klaus-liebler/kicad-libs/smopla.3d/Fan_Assembly.stp

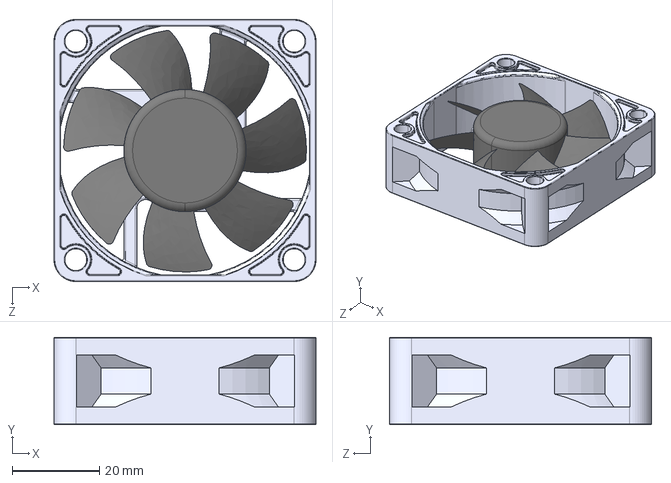
[picture p1: CAD file, 2021-04-30, last stored version]
smopla.3d/Fan_Assembly.stp
60.0 x 20.0 x 60.0 mm
Fan_Case
Fan
