klaus-liebler/kicad-libs/smopla.3d/HANRUN HR911105A.stp

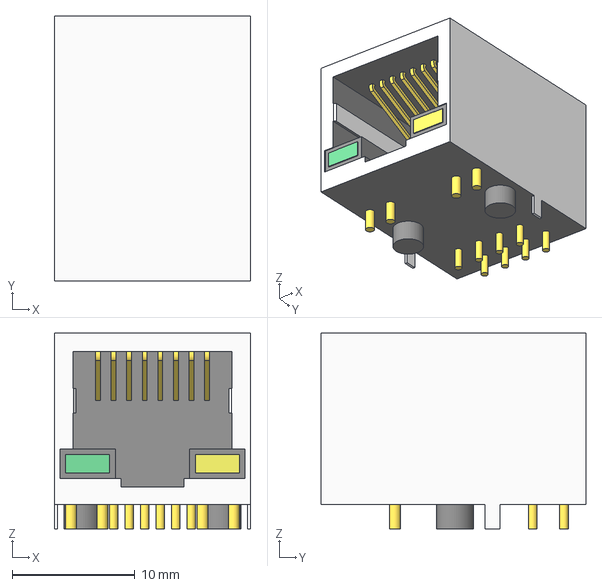
[picture p2: CAD file, 2021-04-30, last stored version]
smopla.3d/HANRUN HR911105A.stp
16.0 x 21.6 x 15.9 mm
contact x 8
