klaus-liebler/kicad-libs/smopla.3d/MiniPIR v1.f3d.__gcx3d__.stp

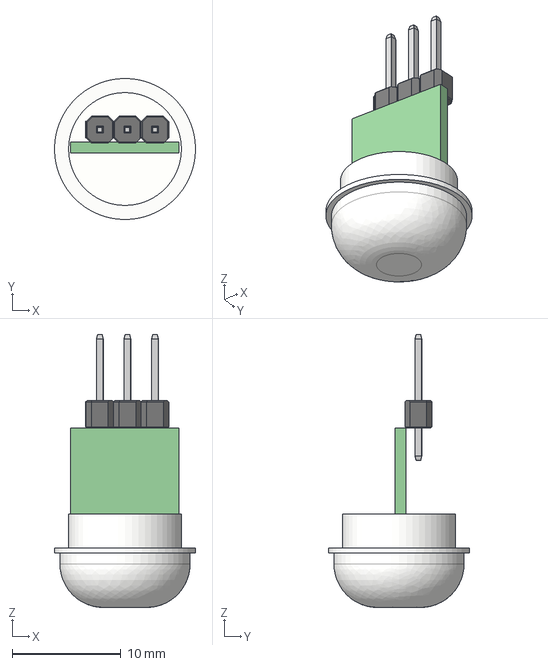
[picture p3: CAD file, 2021-04-30, last stored version]
smopla.3d/MiniPIR v1.f3d.__gcx3d__.stp
13.0 x 13.0 x 25.2 mm
