klaus-liebler/kicad-libs/smopla.3d/Button.SLDPRT

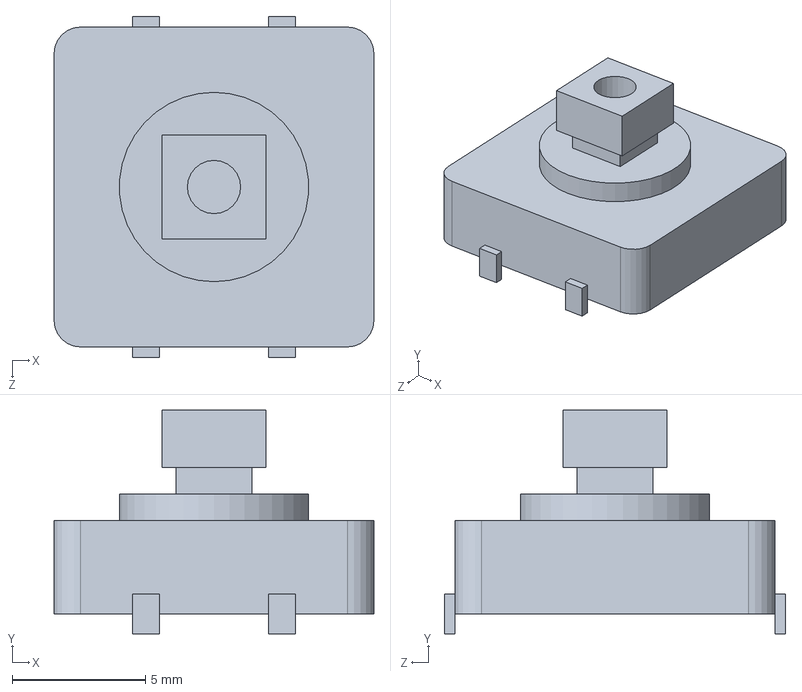
[picture p4: CAD file, 2021-04-30, last stored version]
smopla.3d/Button.SLDPRT
12.0 x 8.40 x 12.8 mm
