klaus-liebler/kicad-libs/smopla.3d/EC11_Rotary_Encoder_Switched.step

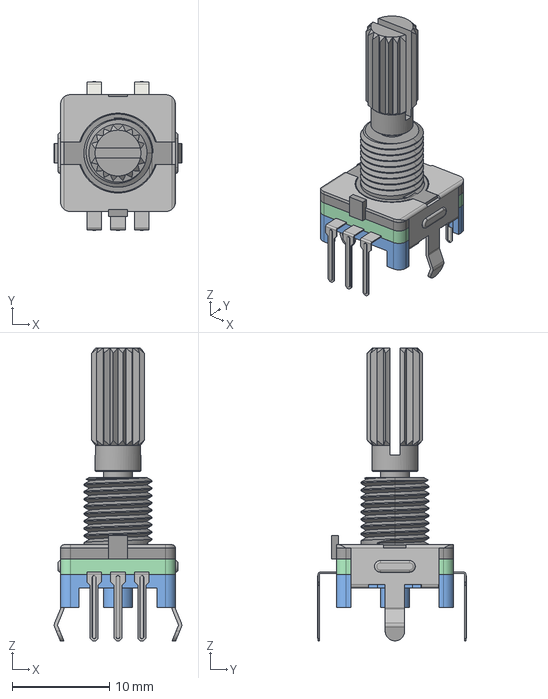
[picture p5: CAD file, 2021-04-30, last stored version]
smopla.3d/EC11_Rotary_Encoder_Switched.step
13.1 x 15.3 x 30.1 mm
