klaus-liebler/kicad-libs/smopla.3d/ALPHA-RD901F-40.step

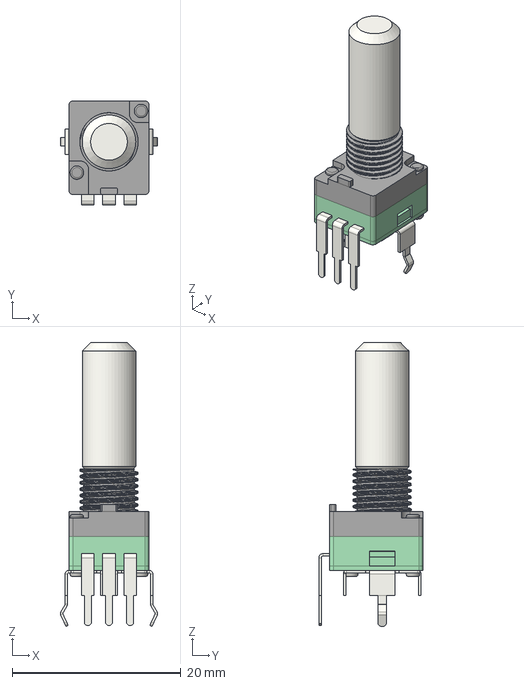
[picture p6: CAD file, 2021-04-30, last stored version]
smopla.3d/ALPHA-RD901F-40.step
11.5 x 12.4 x 33.6 mm
