klaus-liebler/kicad-libs/smopla.3d/Fiche_Banane_Noir.STEP

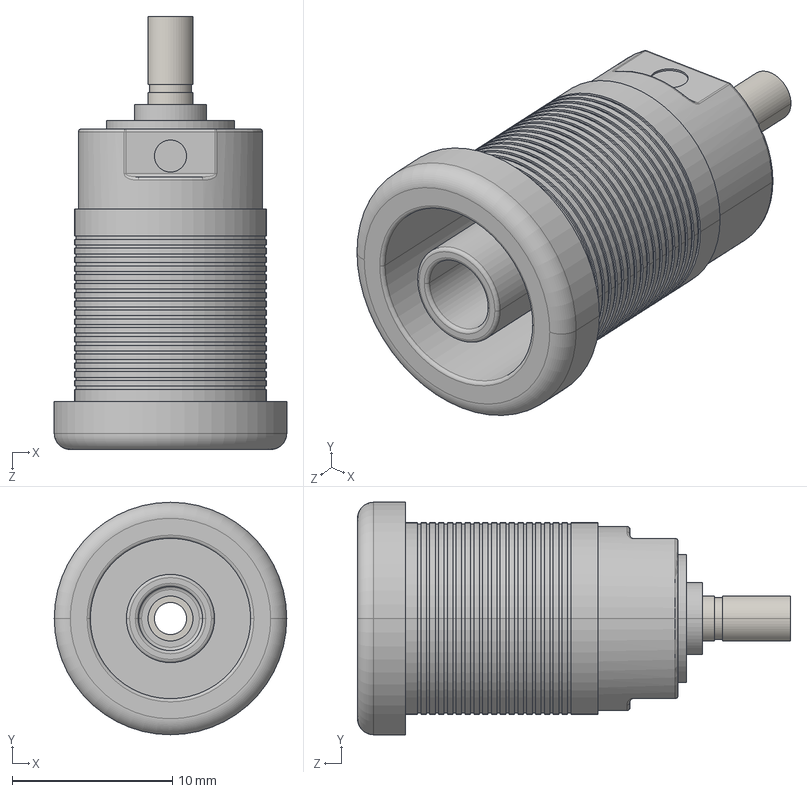
[picture p7: CAD file, 2021-04-30, last stored version]
smopla.3d/Fiche_Banane_Noir.STEP
14.5 x 14.5 x 27.0 mm
