klaus-liebler/kicad-libs/smopla.3d/16Bit I2C ADC+PGA - ADS1115.stp

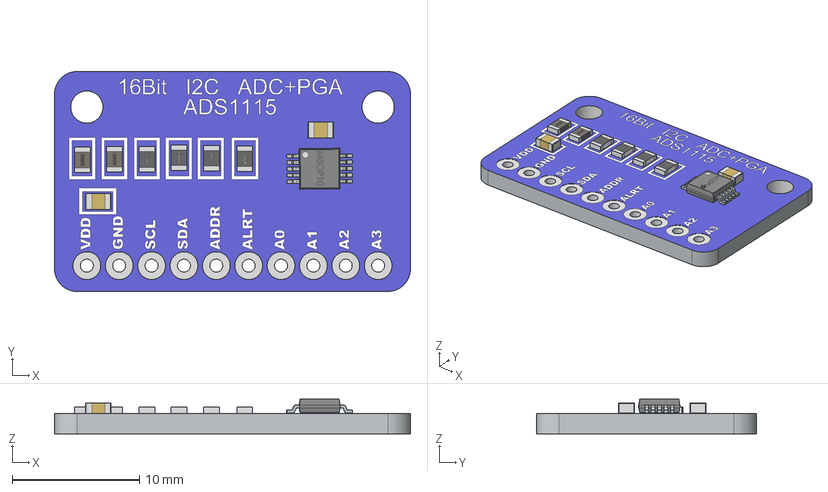
[picture p8: CAD file, 2021-04-30, last stored version]
smopla.3d/16Bit I2C ADC+PGA - ADS1115.stp
27.9 x 17.3 x 2.74 mm
ADS1115
0805 Capacitor x 2
0805 Inductor x 2
0805 Resistor x 4
MSOP10
