klaus-liebler/kicad-libs/smopla.3d/HC-SR501.STEP

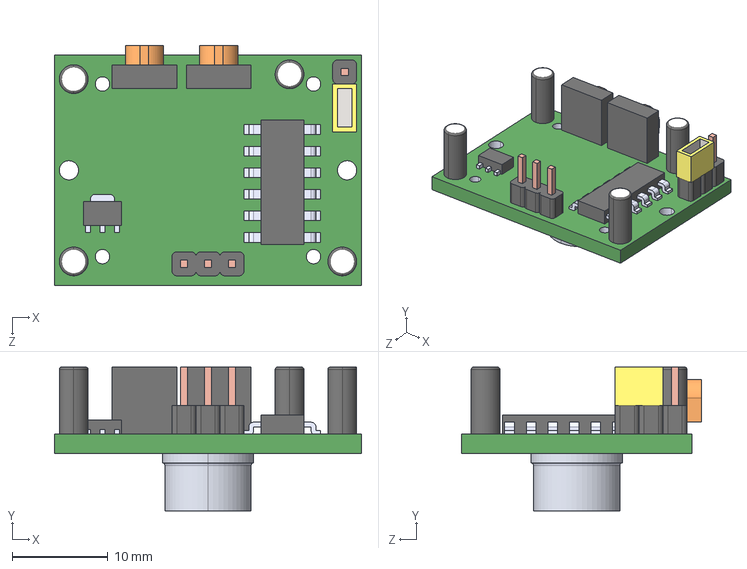
[picture p9: CAD file, 2021-04-30, last stored version]
smopla.3d/HC-SR501.STEP
32.0 x 15.0 x 25.0 mm
