klaus-liebler/kicad-libs/smopla.3d/LED 2835.stp

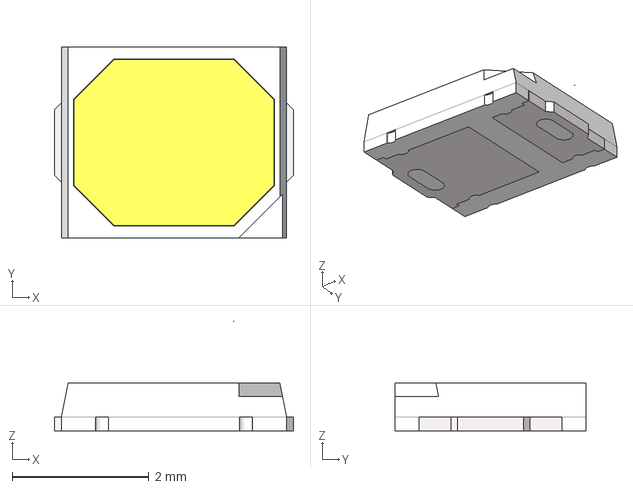
[picture p10: CAD file, 2021-04-30, last stored version]
smopla.3d/LED 2835.stp
3.50 x 2.80 x 1.61 mm
