klaus-liebler/kicad-libs/smopla.3d/ASPI-0630LR.STEP

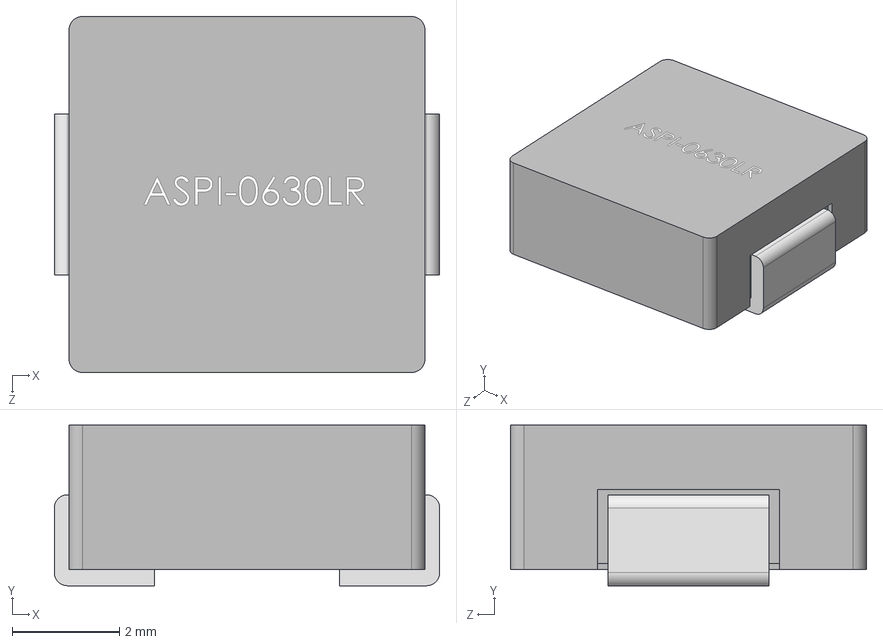
[picture p11: CAD file, 2021-04-30, last stored version]
smopla.3d/ASPI-0630LR.STEP
7.20 x 3.00 x 6.65 mm
