klaus-liebler/kicad-libs/smopla.3d/L-KLS7-SS-12F20A-G5.step

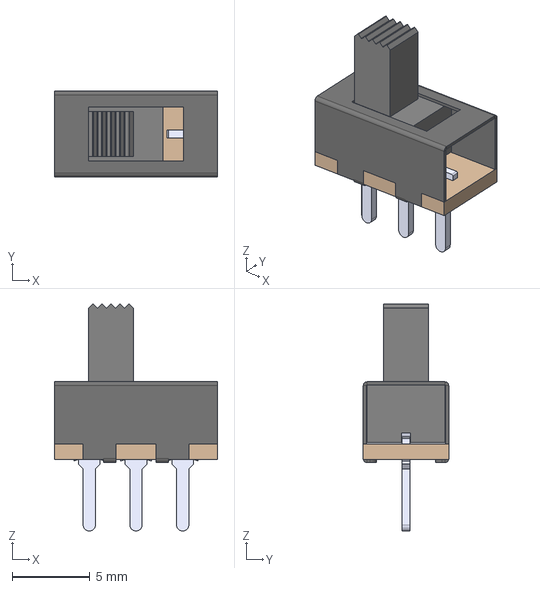
[picture p12: CAD file, 2021-04-30, last stored version]
smopla.3d/L-KLS7-SS-12F20A-G5.step
10.5 x 5.50 x 14.6 mm
