klaus-liebler/kicad-libs/smopla.3d/Large Emitter.STEP

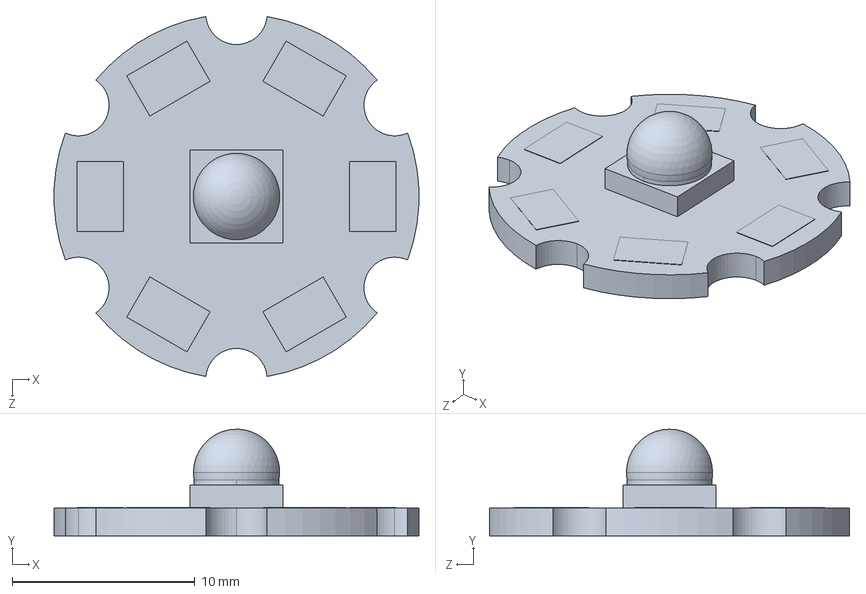
[picture p13: CAD file, 2021-04-30, last stored version]
smopla.3d/Large Emitter.STEP
20.0 x 5.84 x 19.7 mm
