klaus-liebler/kicad-libs/smopla.3d/SKRHAB.STEP

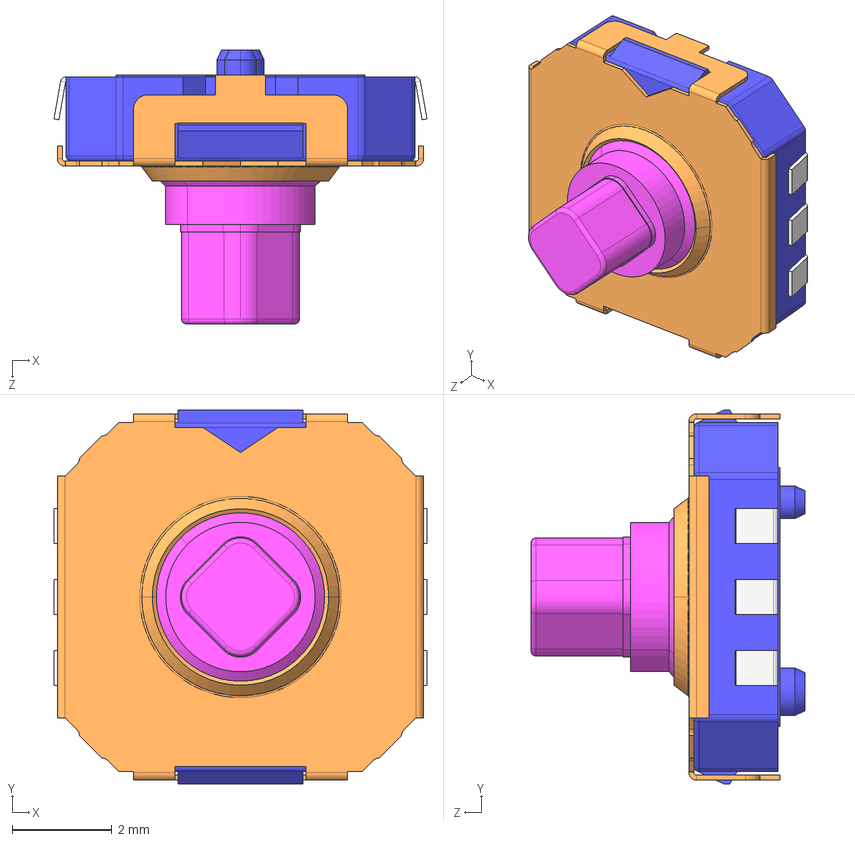
[picture p14: CAD file, 2021-04-30, last stored version]
smopla.3d/SKRHAB.STEP
7.48 x 7.50 x 5.50 mm
