klaus-liebler/kicad-libs/smopla.3d/PIR SR602.step

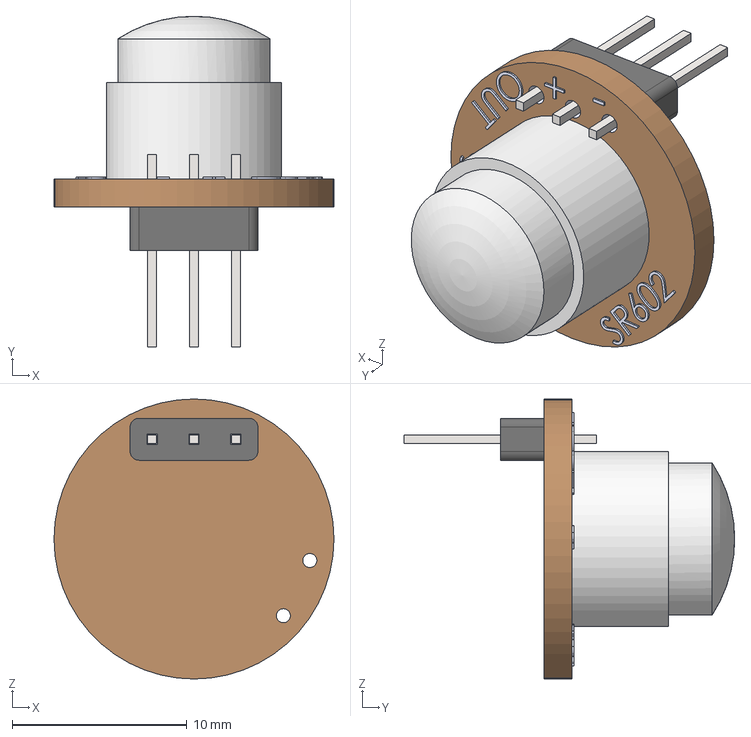
[picture p15: CAD file, 2021-04-30, last stored version]
smopla.3d/PIR SR602.step
16.0 x 18.9 x 16.0 mm
