klaus-liebler/kicad-libs/smopla.3d/WS2812B-8.step

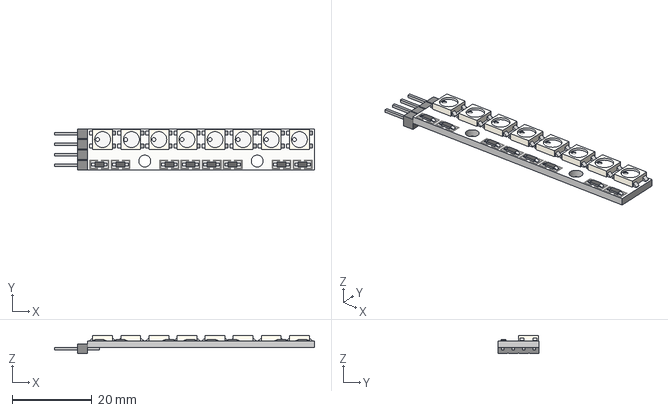
[picture p16: CAD file, 2021-04-30, last stored version]
smopla.3d/WS2812B-8.step
65.4 x 10.4 x 4.65 mm
