klaus-liebler/kicad-libs/smopla.3d/Poti_10kohm.stp

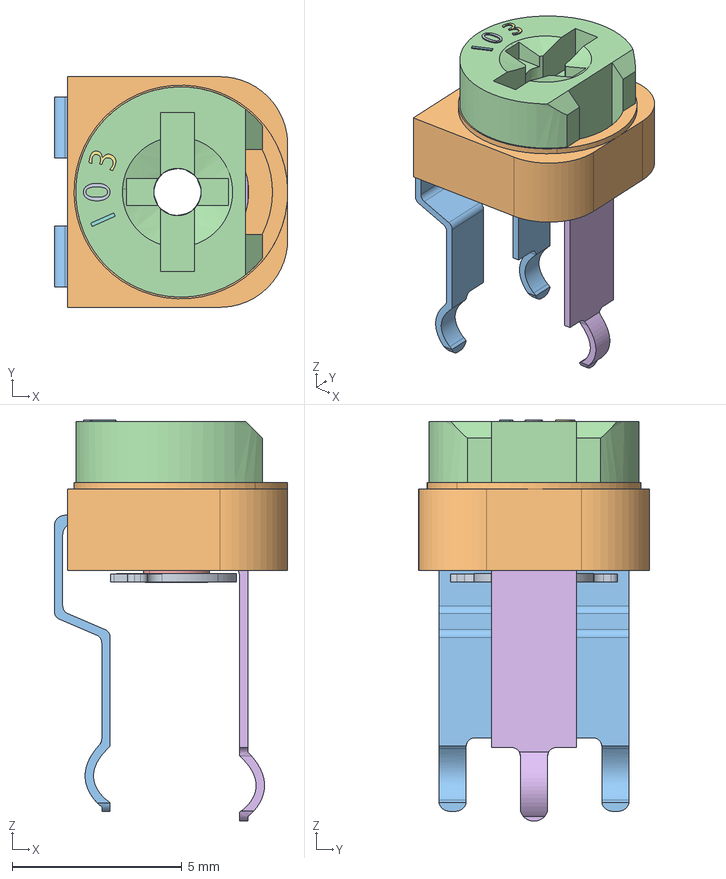
[picture p17: CAD file, 2021-04-30, last stored version]
smopla.3d/Poti_10kohm.stp
6.88 x 6.80 x 11.8 mm
