klaus-liebler/kicad-libs/smopla.3d/TactileButton(5mm)_SMD.stp

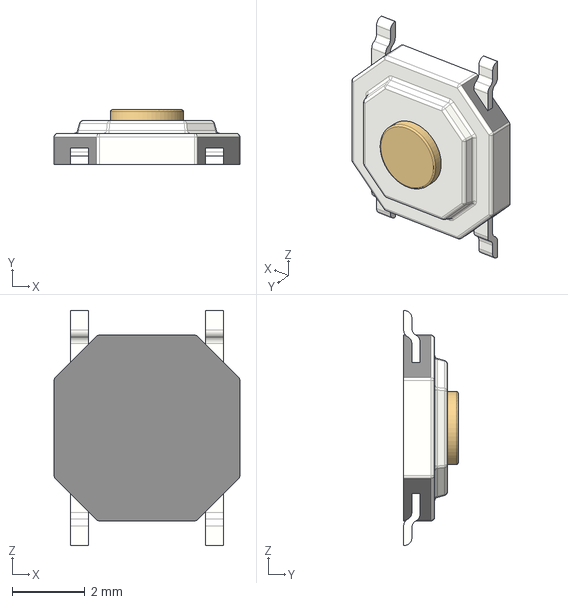
[picture p18: CAD file, 2021-04-30, last stored version]
smopla.3d/TactileButton(5mm)_SMD.stp
5.10 x 1.50 x 6.45 mm
