klaus-liebler/kicad-libs/smopla.3d/INMP441_module v4.step

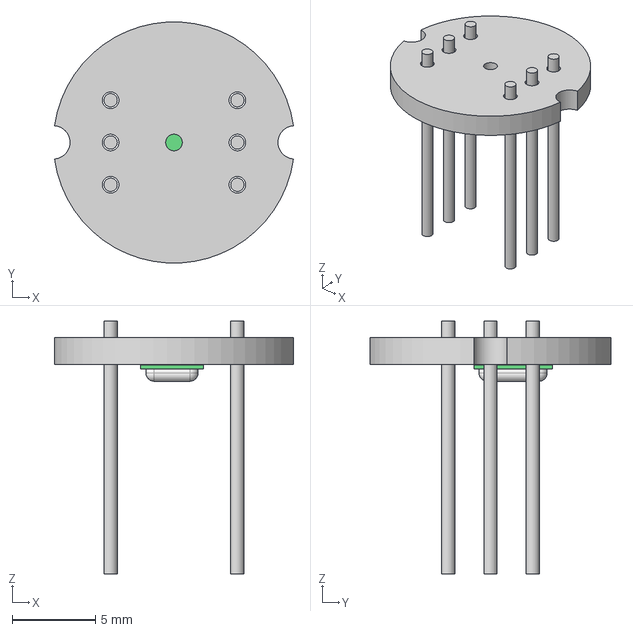
[picture p19: CAD file, 2021-04-30, last stored version]
smopla.3d/INMP441_module v4.step
14.4 x 14.5 x 15.2 mm
Product
pins
