klaus-liebler/kicad-libs/smopla.3d/ms4525-ds-p_p2-54_l17-4_w12-4.stp

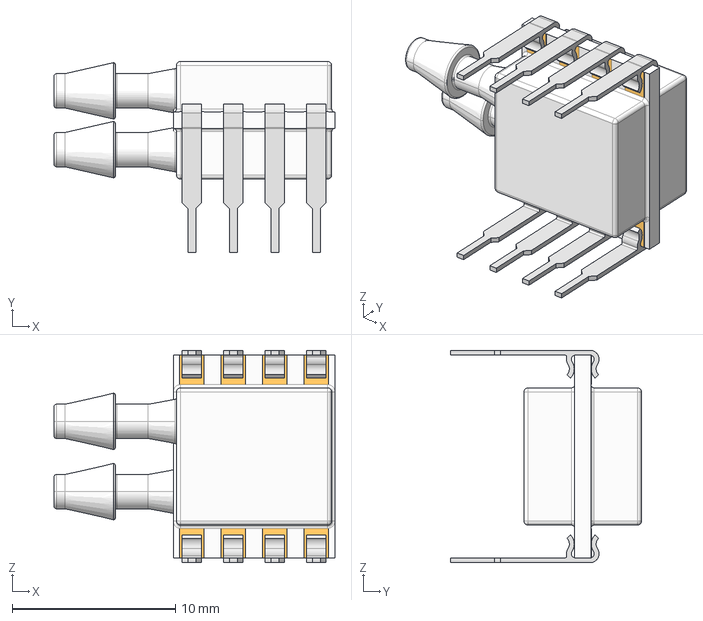
[picture p20: CAD file, 2021-04-30, last stored version]
smopla.3d/ms4525-ds-p_p2-54_l17-4_w12-4.stp
17.2 x 11.7 x 13.0 mm
