klaus-liebler/kicad-libs/smopla.3d/Resistor 100W.stp

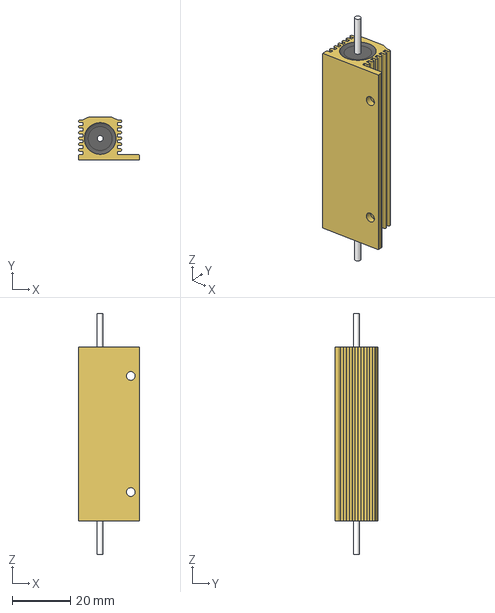
[picture p21: CAD file, 2021-04-30, last stored version]
smopla.3d/Resistor 100W.stp
21.0 x 14.9 x 83.0 mm
