klaus-liebler/kicad-libs/smopla.3d/HRO_TYPE-C-31-M-12.step

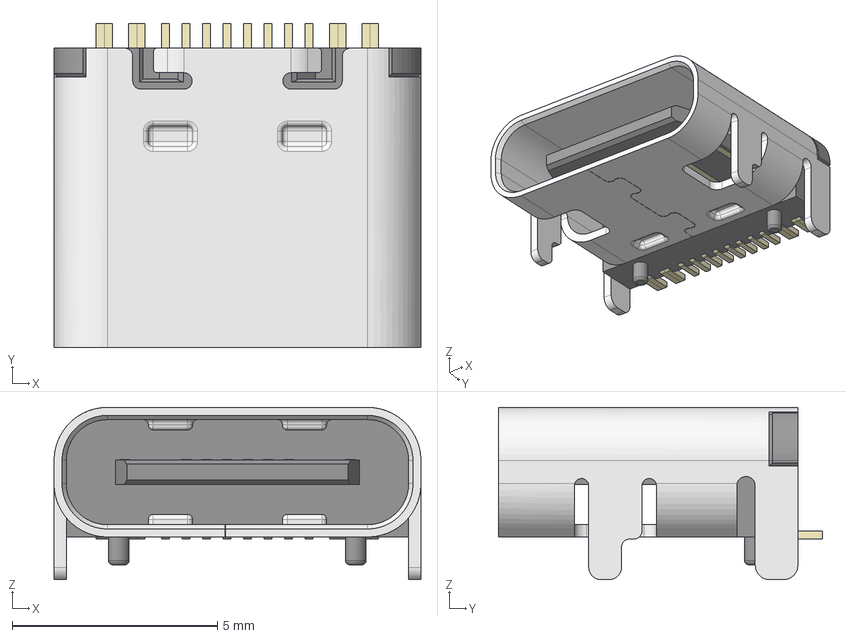
[picture p22: CAD file, 2021-04-30, last stored version]
smopla.3d/HRO_TYPE-C-31-M-12.step
8.95 x 7.90 x 4.20 mm
