klaus-liebler/kicad-libs/smopla.3d/FPC-10.stp

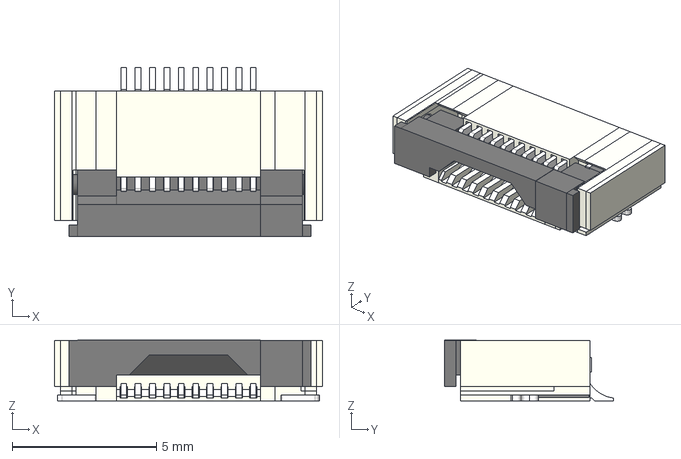
[picture p23: CAD file, 2021-04-30, last stored version]
smopla.3d/FPC-10.stp
9.30 x 5.85 x 2.11 mm
