klaus-liebler/kicad-libs/smopla.3d/Button_SMD_6x6.STEP

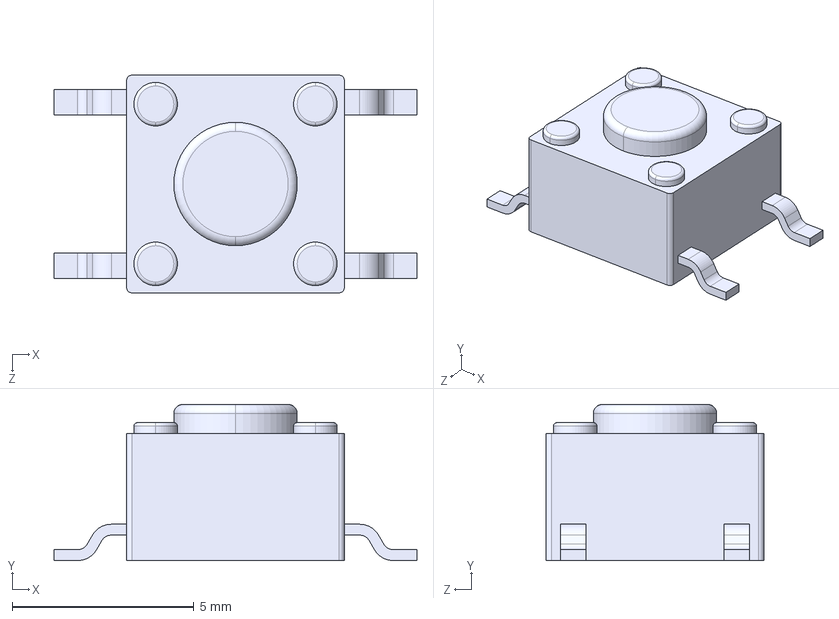
[picture p24: CAD file, 2021-04-30, last stored version]
smopla.3d/Button_SMD_6x6.STEP
10.0 x 4.30 x 6.00 mm
