klaus-liebler/kicad-libs/smopla.3d/smd-side-push-button-2x4x3-5-mm.step

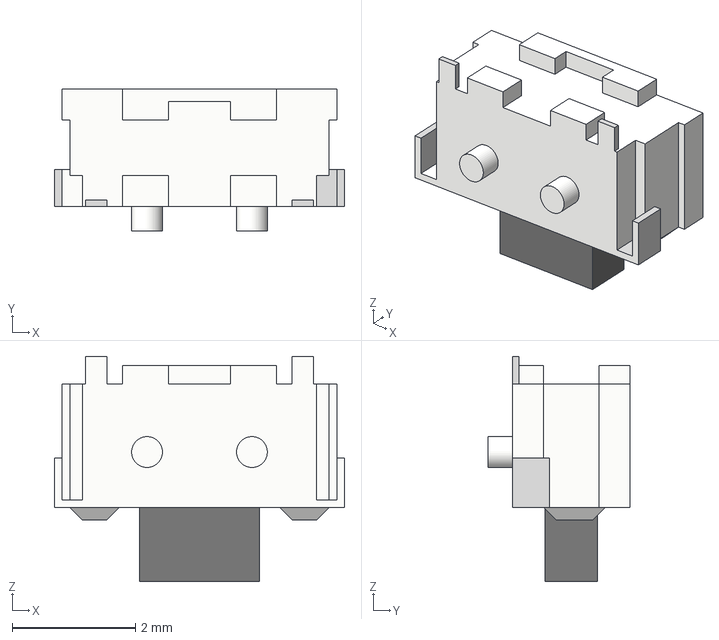
[picture p25: CAD file, 2021-04-30, last stored version]
smopla.3d/smd-side-push-button-2x4x3-5-mm.step
4.70 x 2.30 x 3.65 mm
