klaus-liebler/kicad-libs/smopla.3d/TS6-THT-RA_H-4.3.step

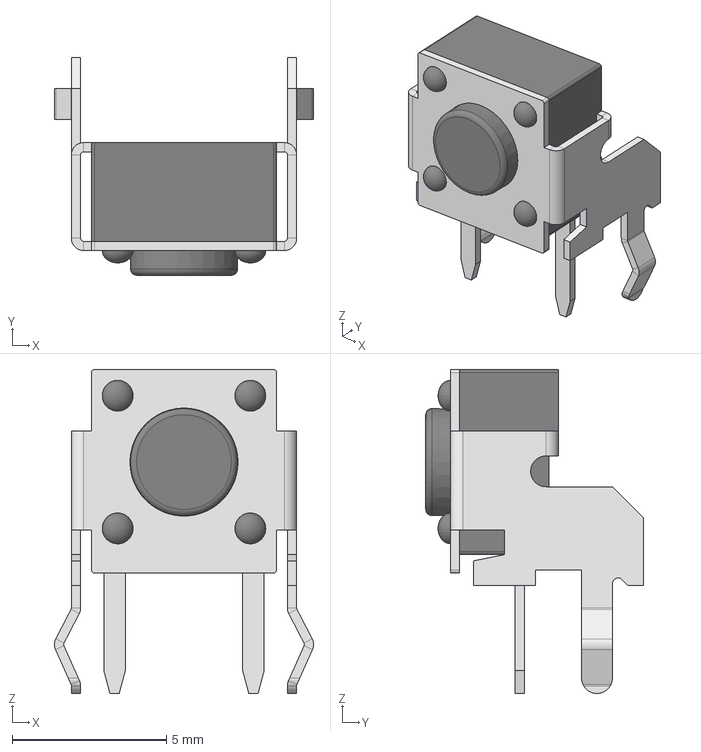
[picture p26: CAD file, 2021-04-30, last stored version]
smopla.3d/TS6-THT-RA_H-4.3.step
8.40 x 7.05 x 10.5 mm
