klaus-liebler/kicad-libs/smopla.3d/1.14 TFT IPS - 13P - Reverse Mount.stp

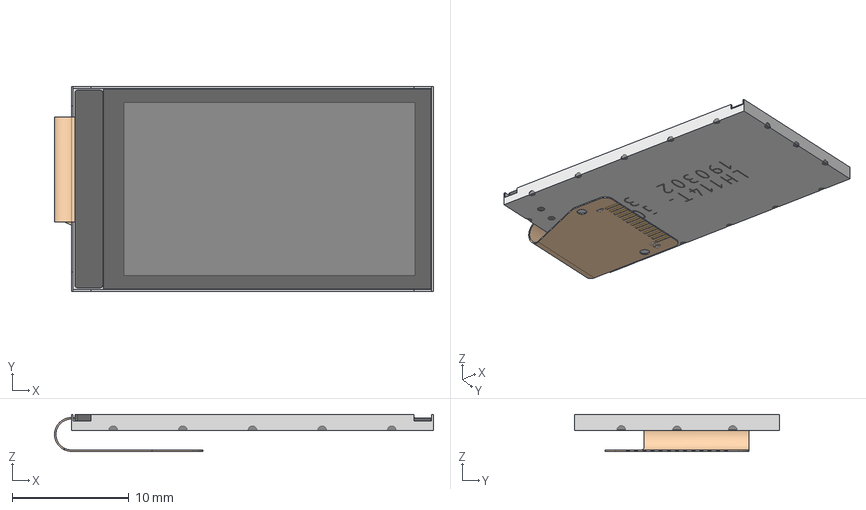
[picture p27: CAD file, 2021-04-30, last stored version]
smopla.3d/1.14 TFT IPS - 13P - Reverse Mount.stp
32.5 x 17.6 x 3.20 mm
