klaus-liebler/kicad-libs/smopla.3d/05KJ_Mini_PCB_Regulator_With_Pin_Assem_.STEP

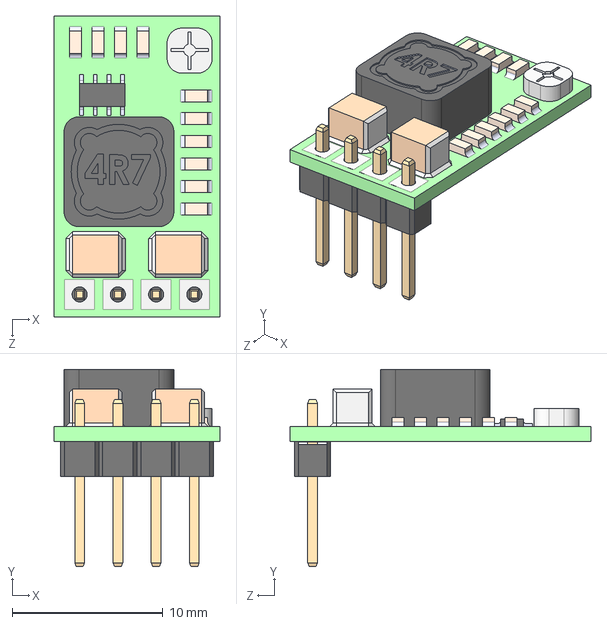
[picture p28: CAD file, 2021-04-30, last stored version]
smopla.3d/05KJ_Mini_PCB_Regulator_With_Pin_Assem_.STEP
11.0 x 13.1 x 20.0 mm
05KJ_Mini_PCB_Regulator
1_Male_Pin_2.54_mm x 4
