klaus-liebler/kicad-libs/smopla.3d/12mm Push button_White n White.stl

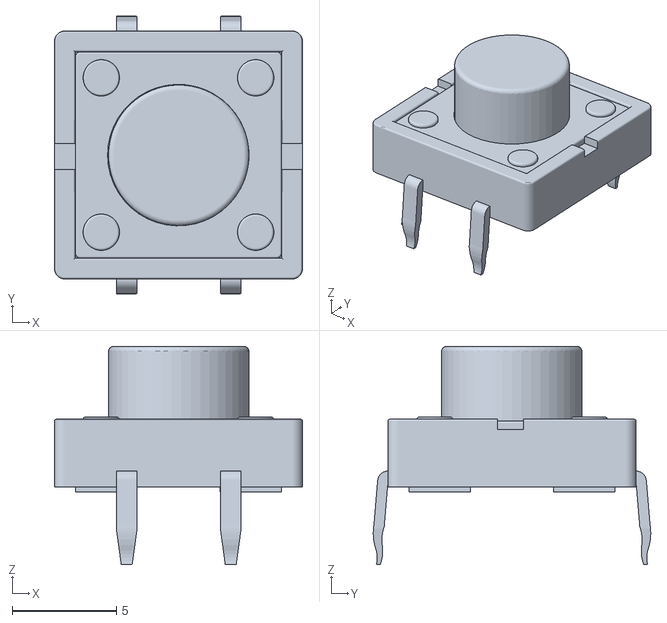
[picture p29: CAD file, 2021-04-30, last stored version]
smopla.3d/12mm Push button_White n White.stl
11.9 x 13.3 x 10.5
