klaus-liebler/kicad-libs/smopla.3d/Tactile Push Button THT 12x12mm H8.50mm (Würth 430476085716).stp

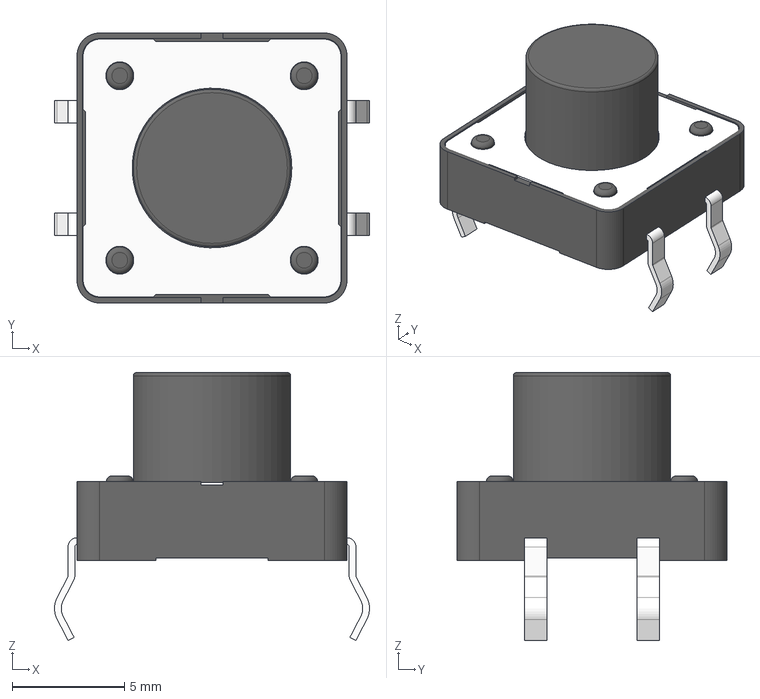
[picture p30: CAD file, 2021-04-30, last stored version]
smopla.3d/Tactile Push Button THT 12x12mm H8.50mm (Würth 430476085716).stp
14.0 x 12.0 x 11.9 mm
