klaus-liebler/kicad-libs/smopla.3d/MiniSpeaker.step

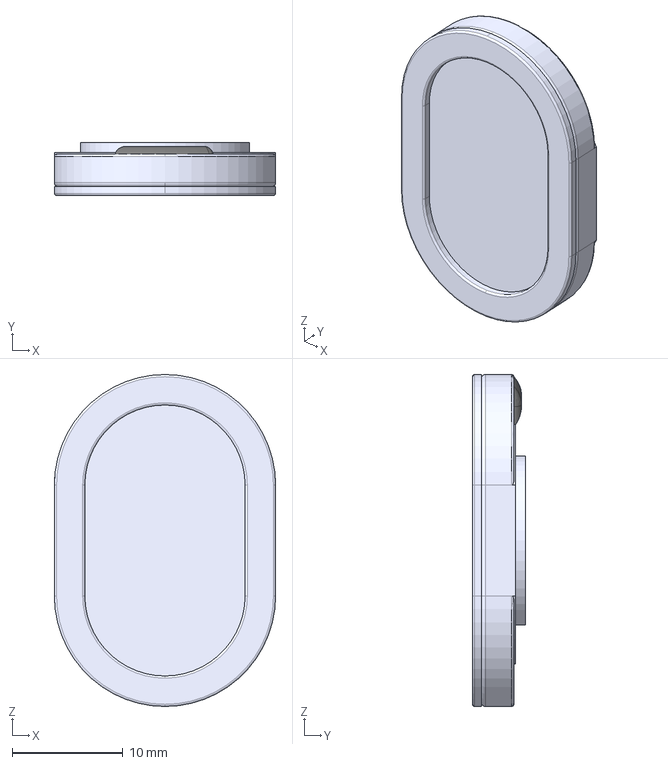
[picture p31: CAD file, 2021-04-30, last stored version]
smopla.3d/MiniSpeaker.step
20.0 x 4.80 x 30.0 mm
