klaus-liebler/kicad-libs/smopla.3d/1.3 TFT IPS - Module.stp

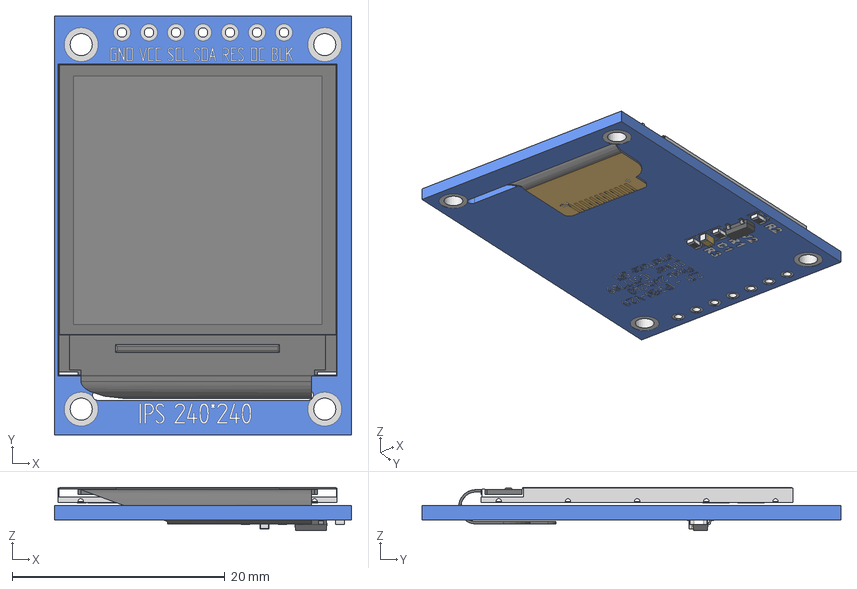
[picture p32: CAD file, 2021-04-30, last stored version]
smopla.3d/1.3 TFT IPS - Module.stp
27.9 x 39.4 x 4.06 mm
1.3 TFT IPS - Board
1.3 TFT IPS - Flush Reverse Mount
0603 Resistor x 3
0603 Capacitor
SOT-23
