klaus-liebler/kicad-libs/smopla.3d/Radial-Cooling-Fan-5015-DC12V.STEP

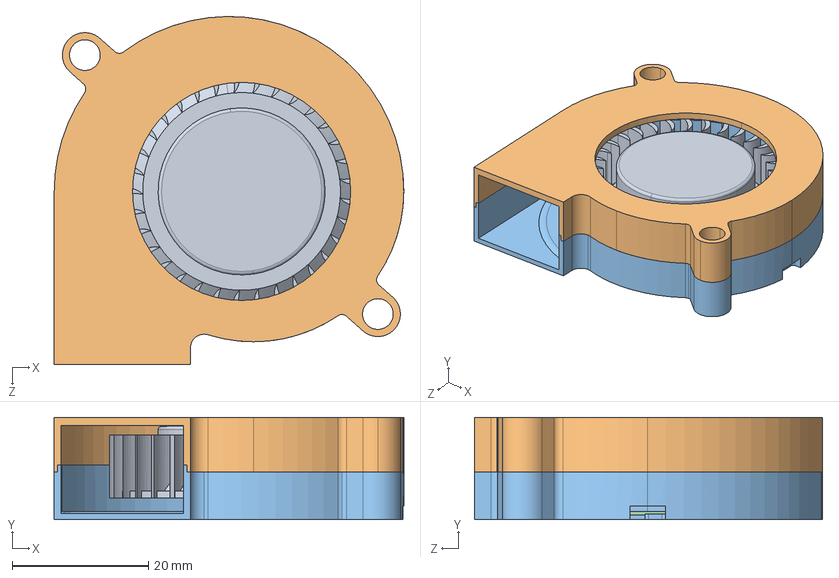
[picture p33: CAD file, 2021-04-30, last stored version]
smopla.3d/Radial-Cooling-Fan-5015-DC12V.STEP
51.3 x 15.0 x 51.1 mm
turbine
top
bottom
