klaus-liebler/kicad-libs/smopla.3d/R-0904N-L-25KCv2.step

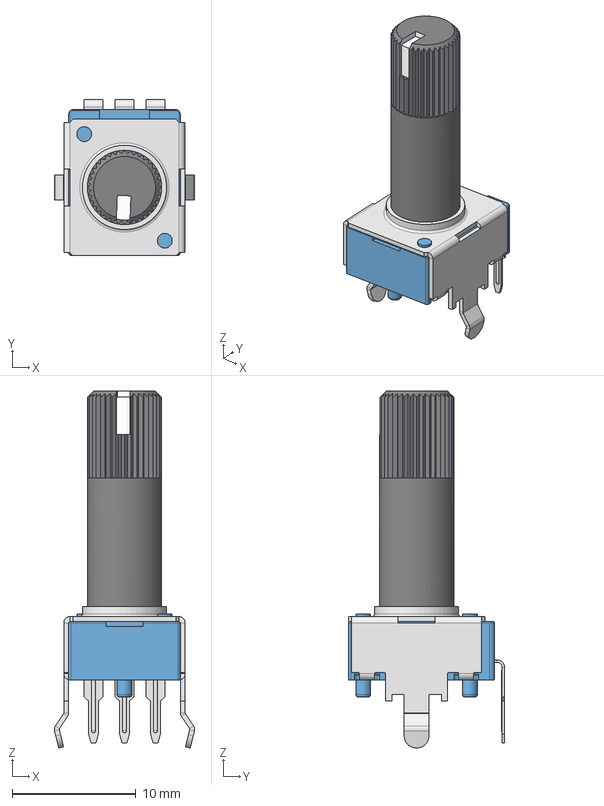
[picture p34: CAD file, 2021-04-30, last stored version]
smopla.3d/R-0904N-L-25KCv2.step
11.3 x 12.6 x 28.8 mm
