klaus-liebler/kicad-libs/smopla.3d/Amphenol 132415.STEP

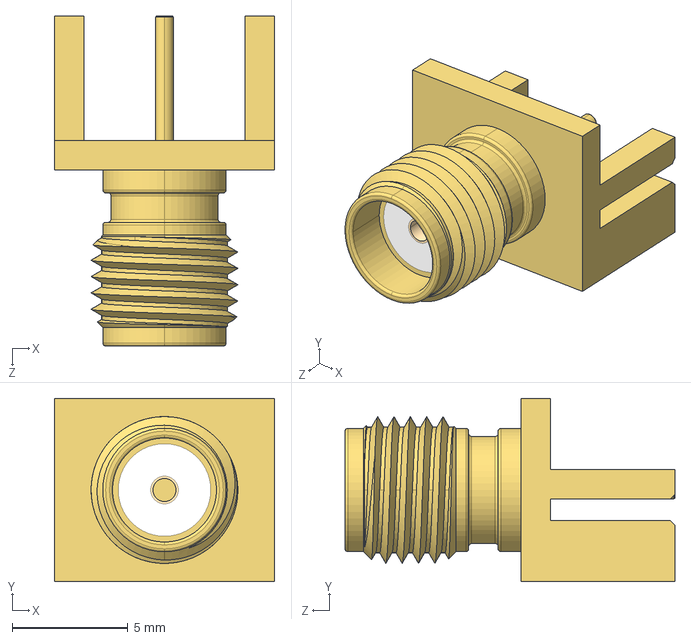
[picture p36: CAD file, 2021-04-30, last stored version]
smopla.3d/Amphenol 132415.STEP
9.52 x 7.92 x 14.3 mm
