klaus-liebler/kicad-libs/smopla.3d/MTS-102.STEP

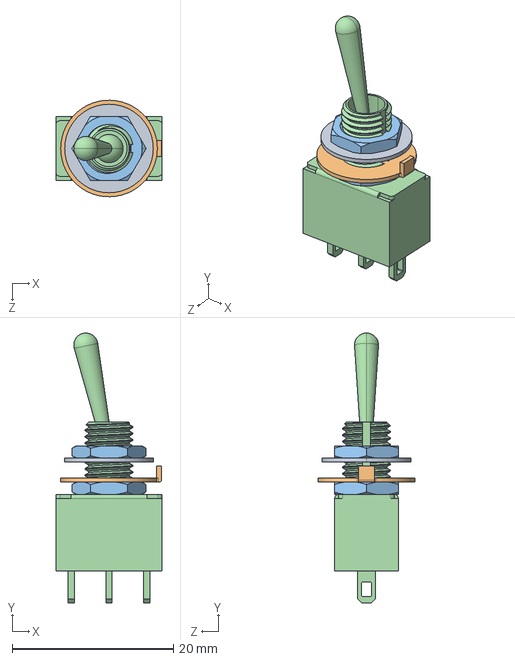
[picture p37: CAD file, 2021-04-30, last stored version]
smopla.3d/MTS-102.STEP
13.2 x 33.5 x 12.0 mm
