klaus-liebler/kicad-libs/smopla.3d/0.96 - IPS LCD - No Glass -8Pin - Reverse Mount.stp

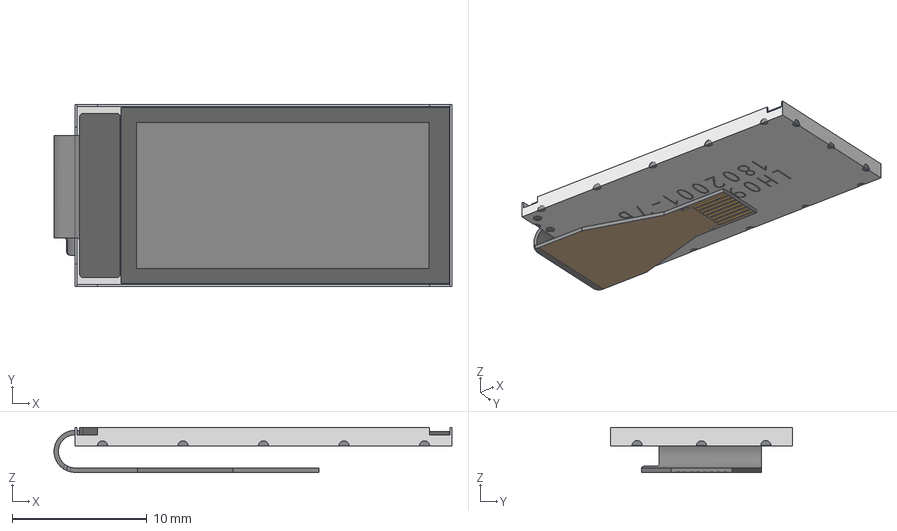
[picture p38: CAD file, 2021-04-30, last stored version]
smopla.3d/0.96 - IPS LCD - No Glass -8Pin - Reverse Mount.stp
29.5 x 13.5 x 3.34 mm
