klaus-liebler/kicad-libs/(list of files, cad)

Other CAD files:
smopla.3d/Large Emitter.stl
