klaus-liebler/kicad-libs/(commit log)

2021-04-30 Various Updates
    [0.96 - IPS LCD - No Glass -8Pin - Reverse Mount.stp, 05KJ_Mini_PCB_Regulator_With_Pin_Assem_.STEP, 1.14 TFT IPS - 13P - Reverse Mount.stp, 1.3 TFT IPS - Module.stp, 12mm Push button_White n White.stl, 16Bit I2C ADC+PGA - ADS1115.stp, ALPHA-RD901F-40.step, ASPI-0630LR.STEP]
2021-05-26 new footprints
2021-07-15 Complete reorganisation
    [HANRUN HR911105A.stp]
2021-11-25 Added various devices
2024-05-21 Updated connectors
2024-06-17 PJ327, microSD-Socket, NAU88C22
2024-08-29 Reverse Mount components
2024-10-08 Mini switch an smd0201
2024-11-12 Various Connectors
2025-02-12 Update ÖLFLEX 4x1mm2.kicad_mod
2025-04-25 Updates to KiCad 9.0
2025-09-02 Improved footprint
2025-10-02 SG90 ESP32-C3 supermini hinge
2026-10-14 XL6009 boost module footprint, USB-C/microSD/connector and semiconductor symbol updates
